ngweibin050-dev/ItemCloud/firmware/esp32_cam_2/secrets.example.h

#pragma once
// Copy to secrets.h (git-ignored) and fill in. Never commit secrets.h.
#define SECRET_WIFI_SSID        "your-wifi-ssid"
#define SECRET_WIFI_PASS        "your-wifi-password"
#define SECRET_CLD_CLOUD_NAME   "your-cloudinary-cloud-name"
#define SECRET_CLD_API_KEY      "your-cloudinary-api-key"
// Google Apps Script web app that returns a signed Cloudinary upload signature
#define SECRET_SIGNER_BASE_URL  "https://script.google.com/macros/s/YOUR_DEPLOYMENT_ID/exec"
#define SECRET_FB_API_KEY       "your-firebase-web-api-key"
#define SECRET_FB_PROJECT_ID    "your-firebase-project-id"
